briilossow/Arduino-Powered-Tensile-Strength-Tester/Presentations/Final_Presentation_Slides.pdf

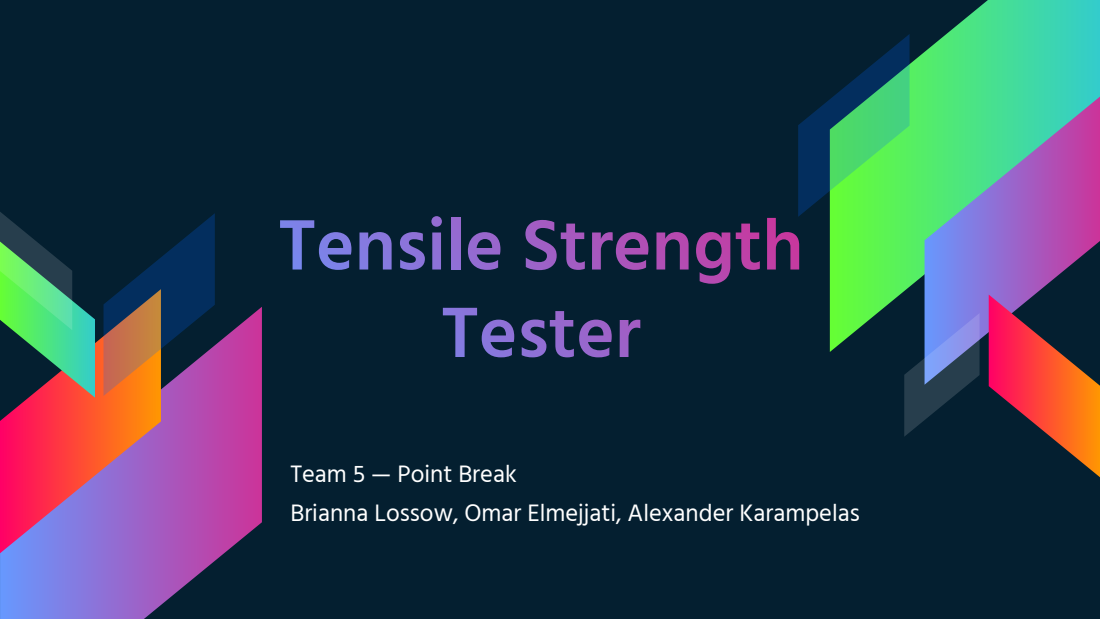
[picture p10: page 1]

Team 5 — Point Break
Brianna Lossow, Omar Elmejjati, Alexander Karampelas

# Overview

› Added touch screen interface for ease of use
› Upgraded clamps to G-clamps
› Upgraded 5kg load cell to 20kg for extra durability › Removed drawer sliders due to excess friction
› Replaced pulling rope with vinyl-wrapped steel cable › Added a pulley for more uniform force application

› Emphasis on stressing the material instead of the user

# Data Collection Procedure

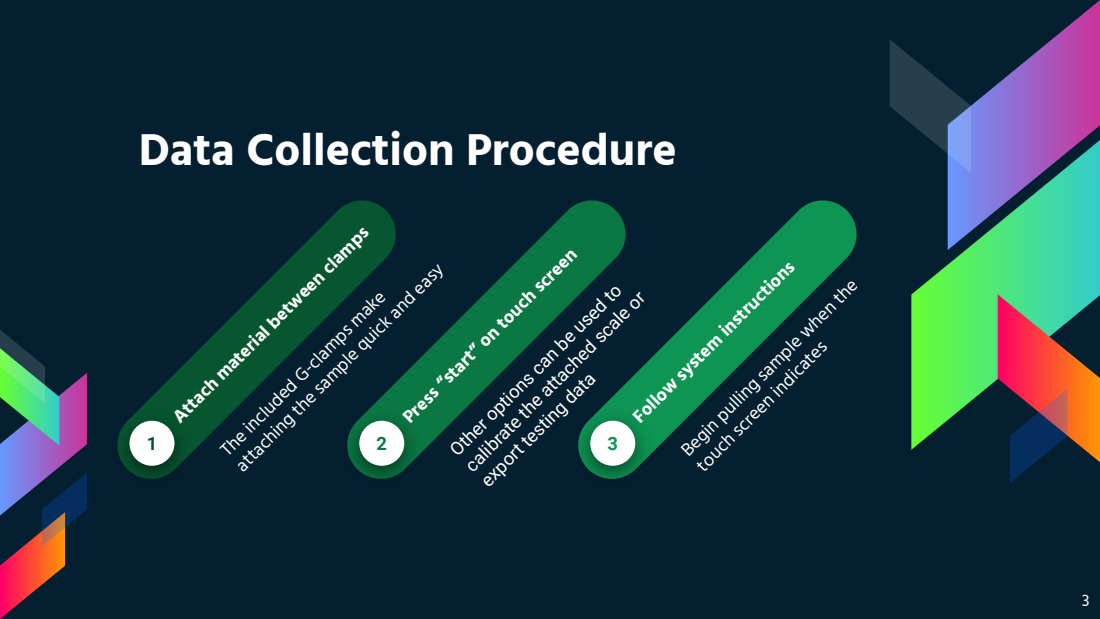
[picture p11: page 3]

Attach material between clamps

Press “start” on touch screen

attaching the sample quick and easy

Follow system instructions

Begin pulling sample when the

The included G-clamps make

Other options can be used to

calibrate the attached scale or

touch screen indicates

export testing data

# Touch Screen User Interface

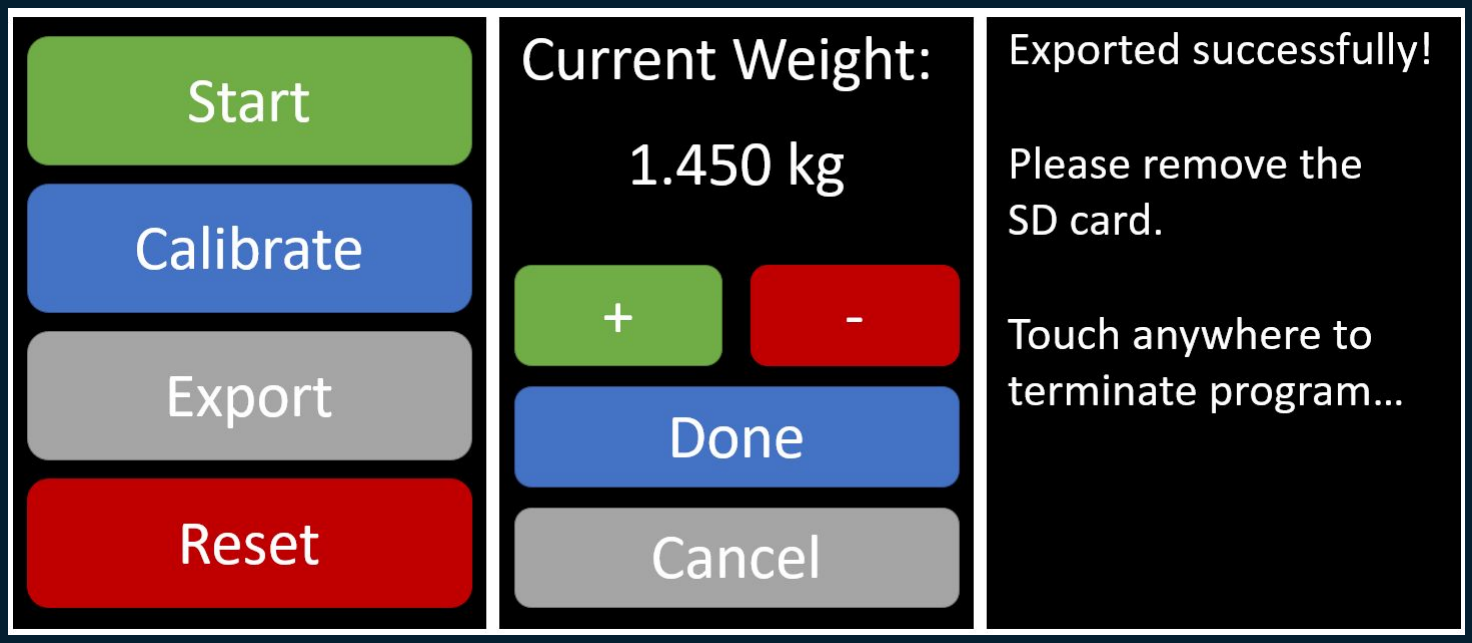
[picture p12: figure]

› Creates an easily-readable interface to allow the user to use the system without requiring an Arduino installation

# Physical Design Model

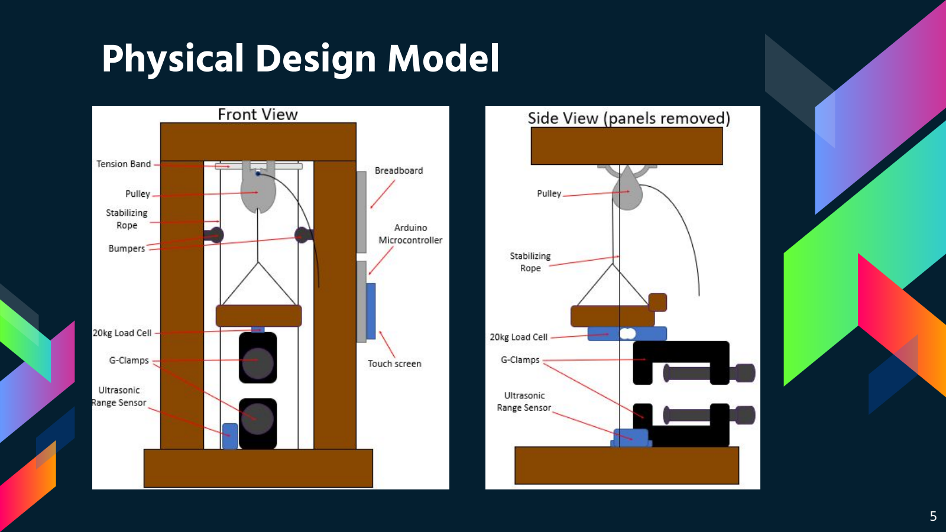
[picture p13: page 5]

# System Data

Our
System

Known
Value Error

Ultimate
Tensile
Strength

Latex 20.5 ± 0.1
MPa

18 - 36
MPa, avg

### 20 MPa

2.5%

Nitrile 14.8 ± 0.1
MPa

14 - 30
MPa, avg

### 16 MPa

7.5%

Young’s
Modulus

Latex 1.35 ± 0.2
MPa

1.2 ± 0.1
MPa | 12.5%
Nitrile | 2.13 ± 0.2
MPa

2.4 ± 0.2
MPa 11.25%

# Stress-Strain Curves

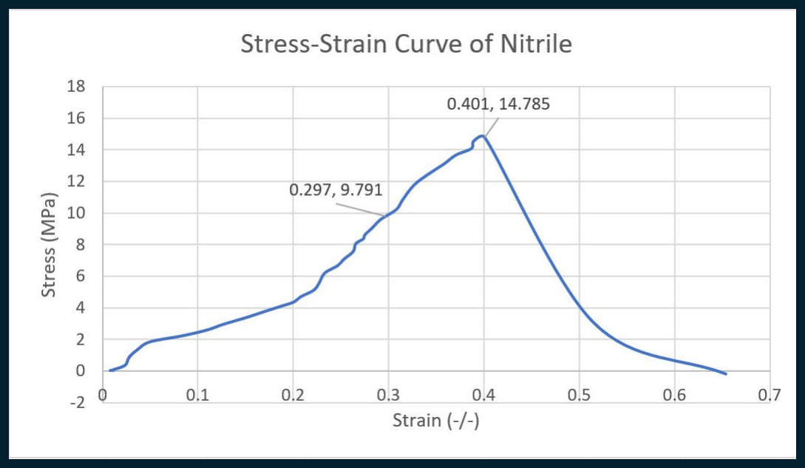
[picture p14: figure]

Nitrile

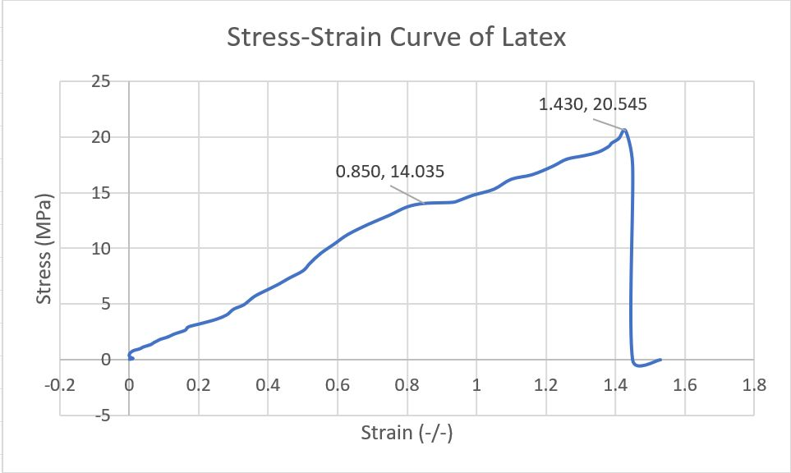
[picture p15: figure]

Latex

# Individual Contributions

Brii
› Software
implementation
› UI design

Alex
› Circuit design
› Hardware
implementation

Omar
› Clamp design
› Calibrated load
cell
› Assisted in
hardware
implementation

Project Budget › Arduino Mega 2560 › 2.8” Touch Screen w/

SD card mount
› microSD Card +
Converter
› Load Cell 20kg › 50lb Fishing Line › Various Hardware

## TOTAL

› $40 › $16 › $14 › $4 › $13

$87

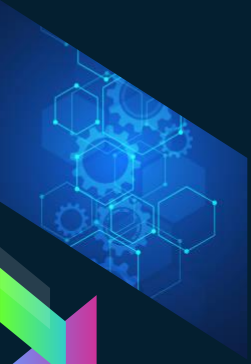
[picture p16: figure]

# THANKS!

## Any questions?
