briilossow/Arduino-Powered-Tensile-Strength-Tester/Miscellaneous/G-Clamp STL Files/clamp_protector.stl

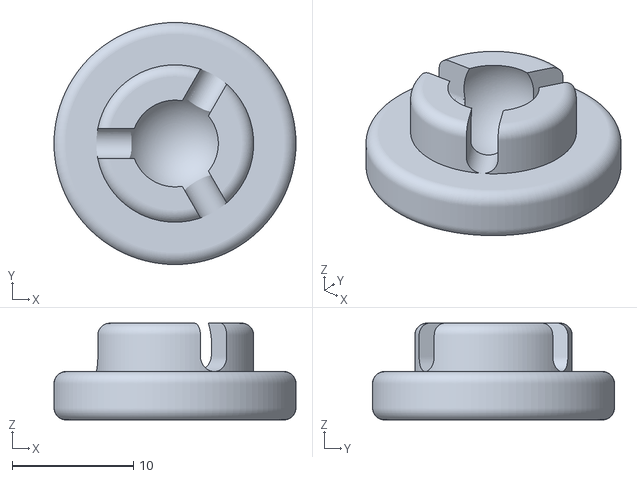
[picture p17: CAD file, 2022-05-03]
Miscellaneous/G-Clamp STL Files/clamp_protector.stl
20.0 x 20.0 x 8.00
