briilossow/Arduino-Powered-Tensile-Strength-Tester/Miscellaneous/G-Clamp STL Files/clamp_frame.stl

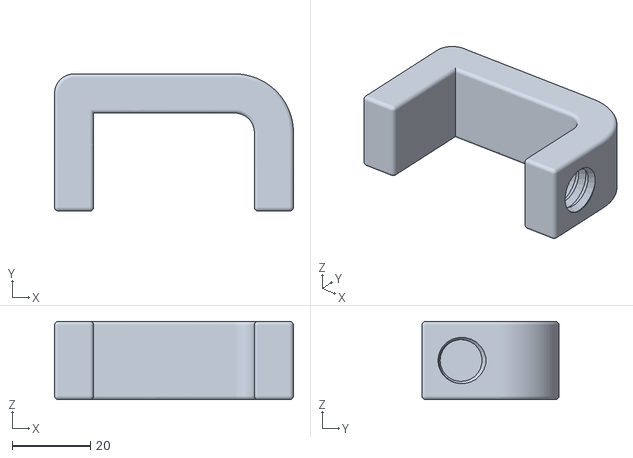
[picture p18: CAD file, 2022-05-03]
Miscellaneous/G-Clamp STL Files/clamp_frame.stl
61.0 x 35.0 x 20.0
