briilossow/Arduino-Powered-Tensile-Strength-Tester/Miscellaneous/G-Clamp STL Files/screw_and_knurled_knobHD.stl

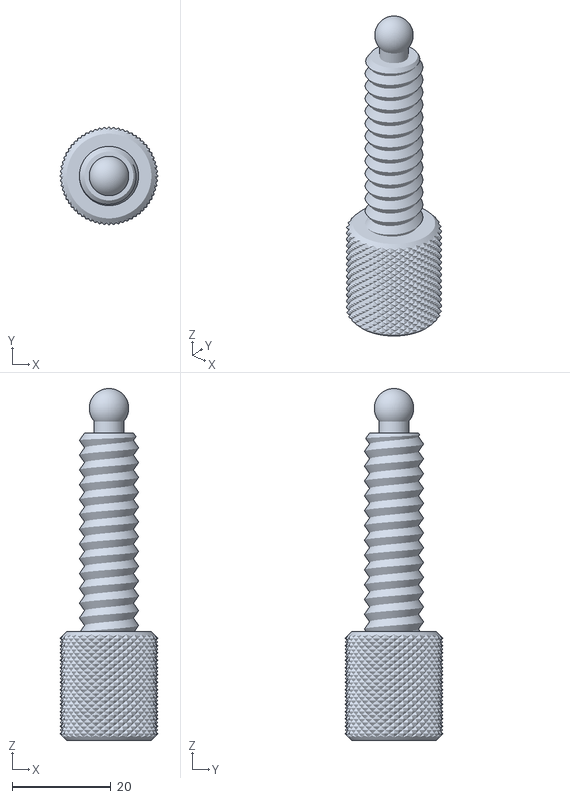
[picture p19: CAD file, 2022-05-03]
Miscellaneous/G-Clamp STL Files/screw_and_knurled_knobHD.stl
19.8 x 19.8 x 71.3
