briilossow/Arduino-Powered-Tensile-Strength-Tester/Reports/Experimental-Results.pdf

PP-2017 V2.1

EXPERIMENTAL DESIGN | 1

# Uniaxial Tensiometer System Experimental Results

Brianna Lossow, Alexander Karampelas, Omar Elmejjati

Activity Report

✦

### 1 RESEARCH QUESTION

The primary goal of our improved uniaxial tensiometer system is to increase system accuracy using software improvements. To demonstrate the accuracy of our system, we tested our system on two different types of material (latex and nitrile) and compared the values of Young’s modulus and ultimate tensile strength computed from the stress-strain curve to known values for these materials.

### 2 EXPERIMENTAL RESULTS

Show the following results of your system.
1) Stress-strain curve for latex glove (See Figure 1).
2) Stress-strain curve for nitrile glove (See Figure 2).
3) Table summarizing key metrics (Young’s Modulus and Ultimate Tensile Strength) derived from stress-strain curves compared to known values from the original research paper (See Table 1).
The graphs visualize the known value for Young’s modulus for both the latex and nitrile gloves as well as the ultimate tensile strengths for both gloves. The experimental error across five trials conducted to achieve these results
- Brianna Lossow,
E-mail: blossow@albany.edu,
- Alexander Karampelas,
E-mail: akarampelas@albany.edu,
- Omar Elmejjati,
E-mail: oelmejjati@albany.edu,
Electrical & Computer Engineering, University at Albany.

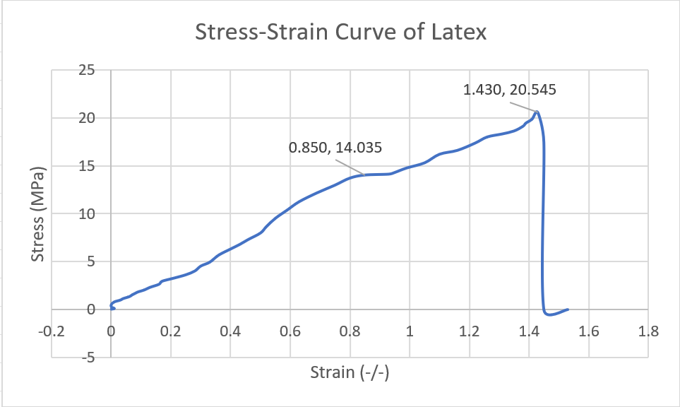
[picture p20: figure]

Figure 1. Stress-strain curve derived from our system for Latex glove sample

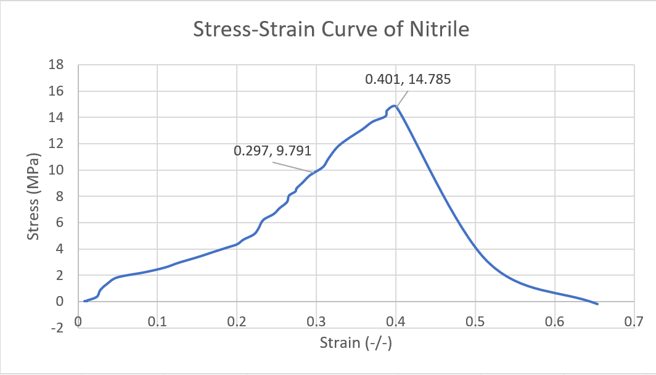
[picture p21: figure]

Figure 2. Stress-strain curve derived from our system for nitrile glove sample

is also provided to see the accuracy of the system. The known values are provided from the American Society for Testing Materials (ASTM), which requires a minimum ultimate tensile strength for latex and nitrile gloves used in exam settings.

Activity Report

2 | EXPERIMENTAL DESIGN
Metric | Sample | # Trials | Our System | Known Value | Error
Young’s Modulus | Latex Glove | 5 | 1.35 ± 0.2 MPa | 1.2 ± 0.1 MPa | ±12.50%
.. | Nitrile Glove | 5 | 2.13 ± 0.2 MPa | 2.4 ± 0.2 MPa | ±11.25%
Ultimate Tensile Strength | Latex Glove | 5 | 20.5 ± 0.1 MPa | 18 - 36 MPa, avg 20 MPa | ±2.5%
.. | Nitrile Glove | 5 | 14.8 ± 0.1 MPa | 14 - 30 MPa, avg 16 MPa | ±7.5%
Table 1
Summary of experimental results from multiple trials

### 3 DATA ANALYSIS
